wdhub/mechatronic-project/CAD_files-frame/bird-wings-mechanism-1.snapshot.3/bird wings/2.jpg

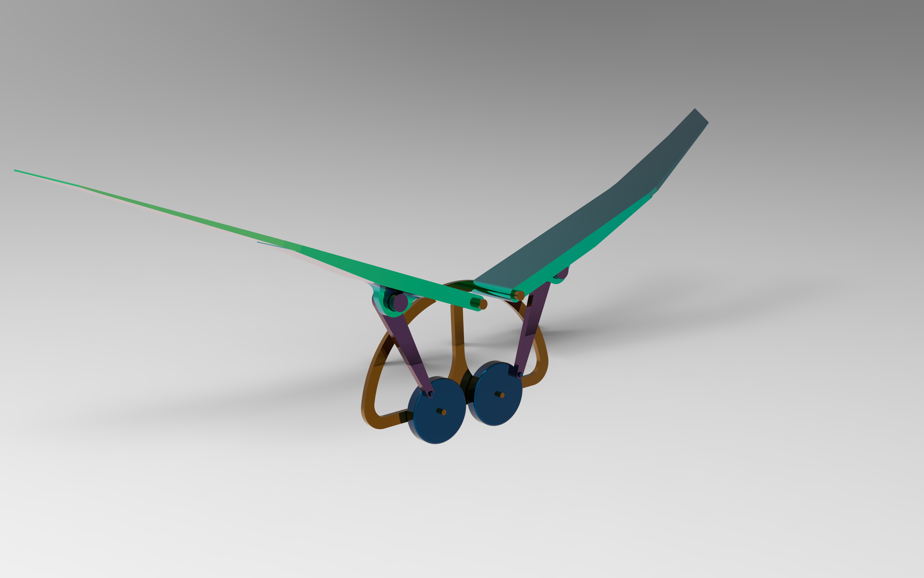
CAD_files-frame/bird-wings-mechanism-1.snapshot.3/bird wings/2.jpg
