wdhub/mechatronic-project/CAD_files-frame/flying-mechanism-1.snapshot.2/untitled.70.png

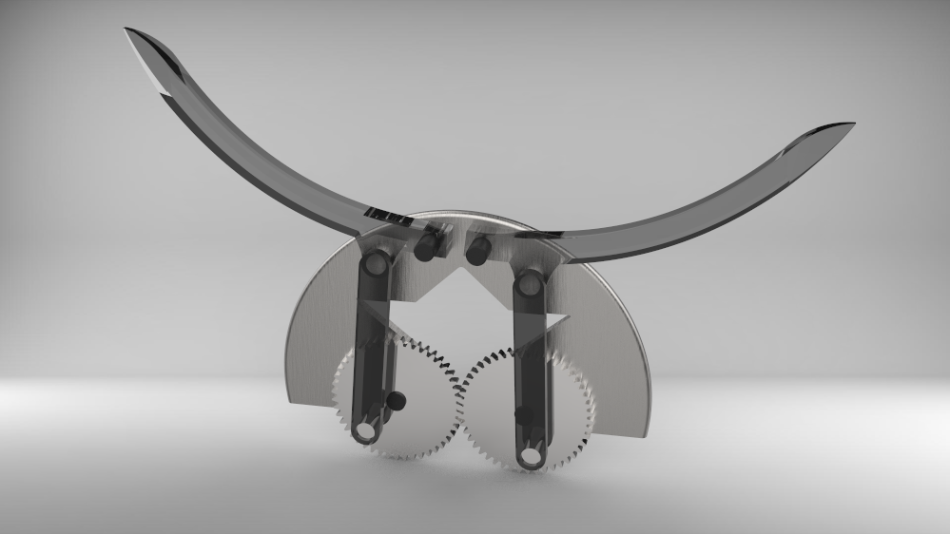
CAD_files-frame/flying-mechanism-1.snapshot.2/untitled.70.png
