wdhub/mechatronic-project/Origami_files_Instructables/Kinetic Origami 3D files-20221115T102837Z-001/Kinetic Origami 3D files/main_gearWithHole.stl

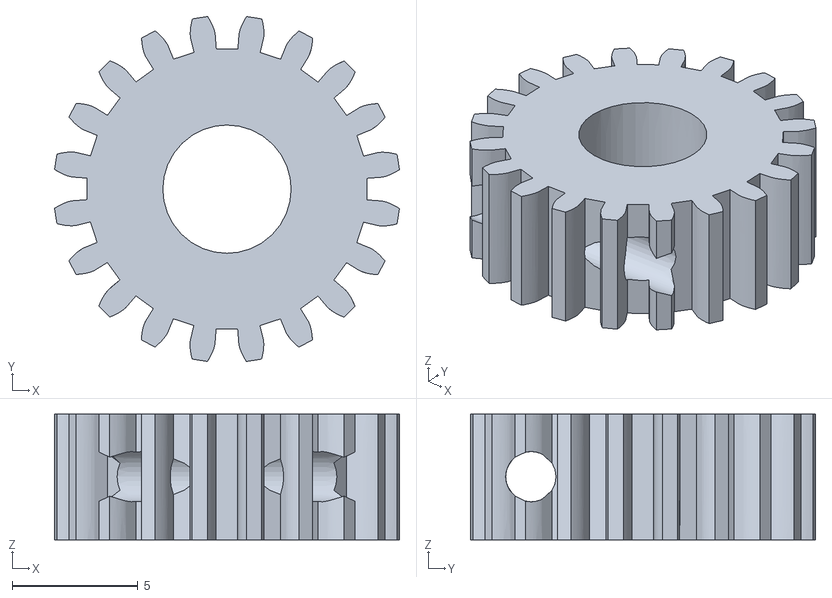
[picture p13: CAD file, 2022-11-28]
Origami_files_Instructables/Kinetic Origami 3D files-20221115T102837Z-001/Kinetic Origami 3D files/main_gearWithHole.stl
13.7 x 13.7 x 5.00
