wdhub/mechatronic-project/CAD_files-frame/flying-mechanism-1.snapshot.2/Assem1.SLDASM

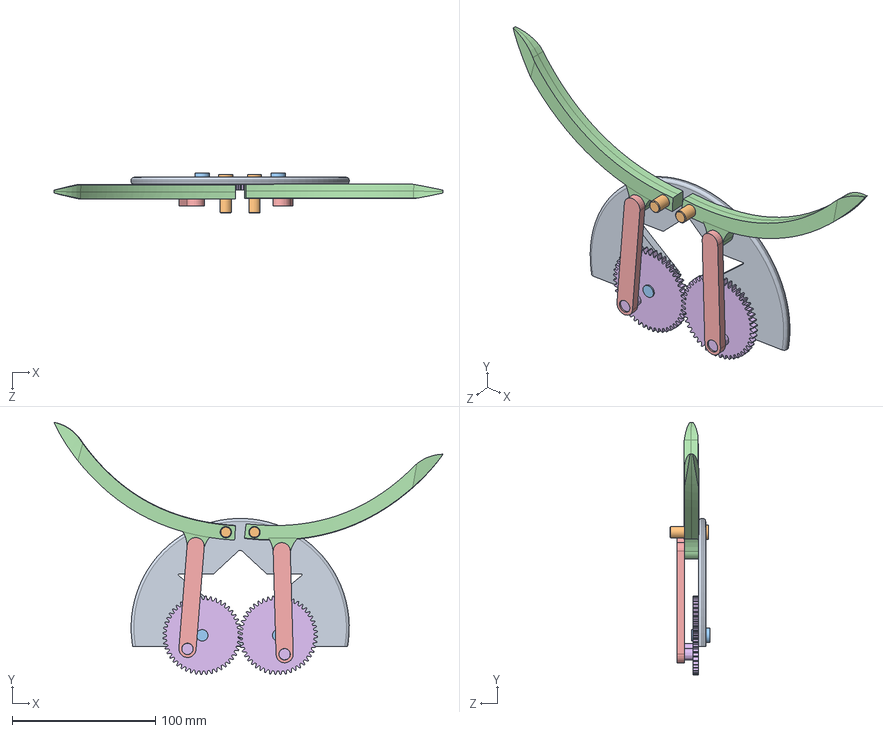
[picture p14: CAD file, 2022-12-14]
CAD_files-frame/flying-mechanism-1.snapshot.2/Assem1.SLDASM
271.6 x 176.3 x 28.0 mm
wing x 2
spur gear_ x 2
