wdhub/mechatronic-project/Origami_files_Instructables/Kinetic Origami 3D files-20221115T102837Z-001/Kinetic Origami 3D files/main_gearHolder.stl

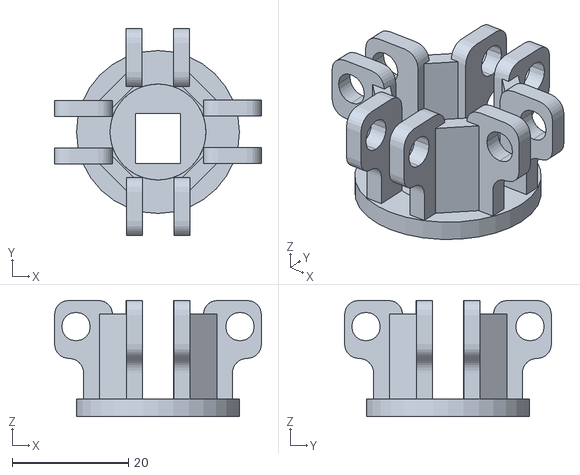
[picture p15: CAD file, 2022-11-28]
Origami_files_Instructables/Kinetic Origami 3D files-20221115T102837Z-001/Kinetic Origami 3D files/main_gearHolder.stl
35.6 x 35.6 x 20.0
