wdhub/mechatronic-project/CAD-20221125T085707Z-001/CAD/cylinder-1.stl

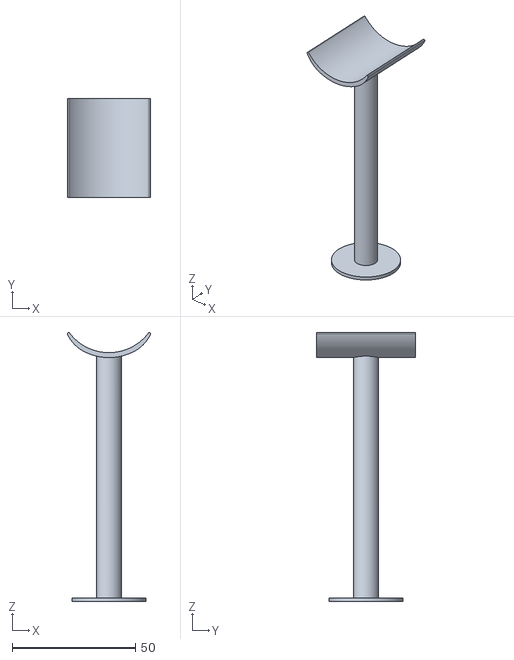
[picture p16: CAD file, 2022-12-14]
CAD-20221125T085707Z-001/CAD/cylinder-1.stl
33.7 x 40.0 x 109.0
