wdhub/mechatronic-project/CAD_files-frame/flying-mechanism-1.snapshot.2/Part8.SLDPRT

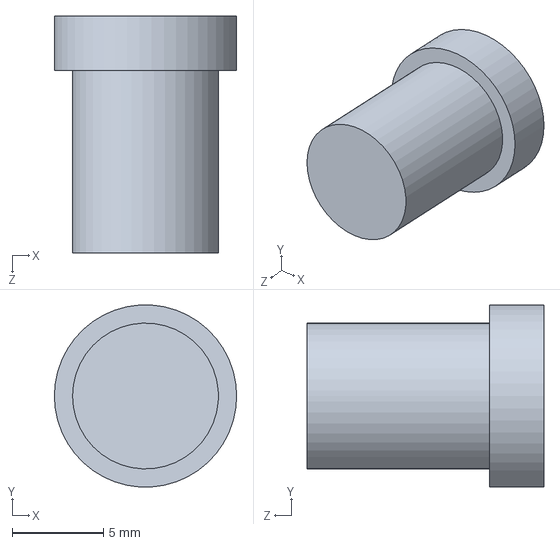
[picture p17: CAD file, 2022-12-14]
CAD_files-frame/flying-mechanism-1.snapshot.2/Part8.SLDPRT
10.0 x 9.98 x 13.0 mm
