wdhub/mechatronic-project/CAD-20221125T085707Z-001/CAD/Base-Bottom-1.stl

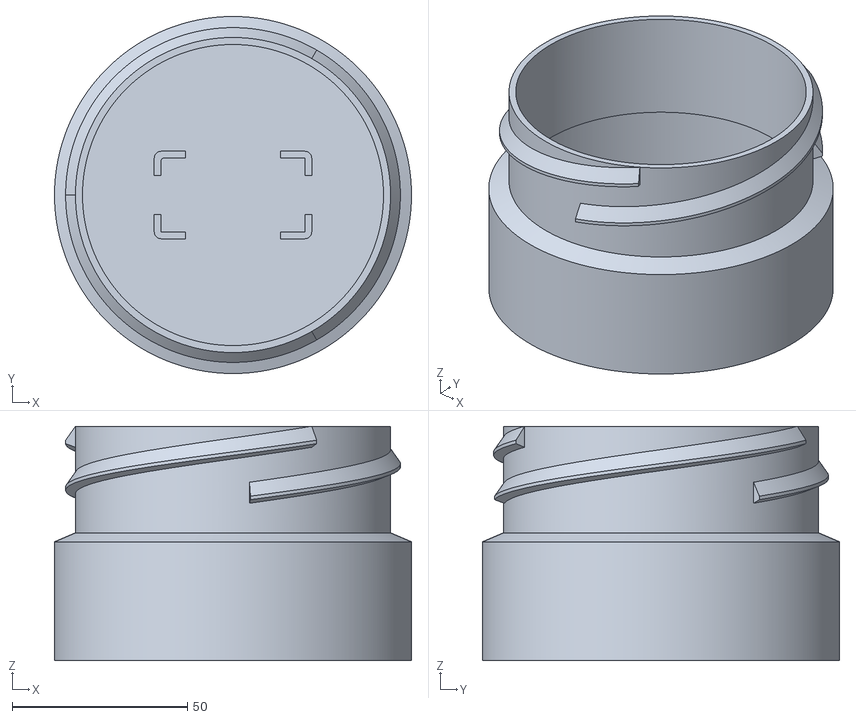
[picture p18: CAD file, 2022-12-14]
CAD-20221125T085707Z-001/CAD/Base-Bottom-1.stl
102.0 x 102.0 x 67.0
