wdhub/mechatronic-project/CAD_files-frame/flying-mechanism-1.snapshot.2/Part10.SLDPRT

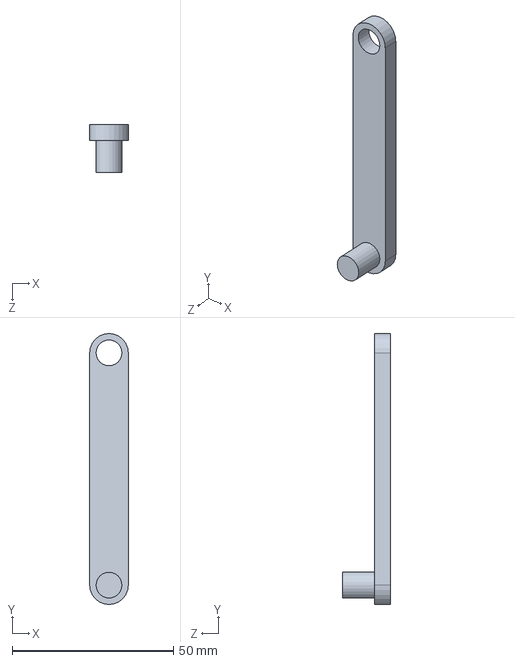
[picture p19: CAD file, 2022-12-14]
CAD_files-frame/flying-mechanism-1.snapshot.2/Part10.SLDPRT
12.0 x 84.0 x 15.0 mm
