wdhub/mechatronic-project/Origami_files_Instructables/Kinetic Origami 3D files-20221115T102837Z-001/Kinetic Origami 3D files/servo_gear.stl

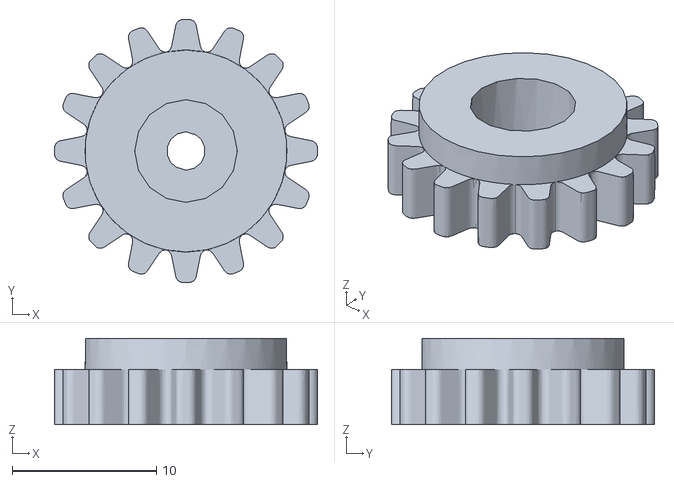
[picture p20: CAD file, 2022-11-28]
Origami_files_Instructables/Kinetic Origami 3D files-20221115T102837Z-001/Kinetic Origami 3D files/servo_gear.stl
18.2 x 18.2 x 5.97
