wdhub/mechatronic-project/Origami_files_Instructables/Kinetic Origami 3D files-20221115T102837Z-001/Kinetic Origami 3D files/servo_holder.stl

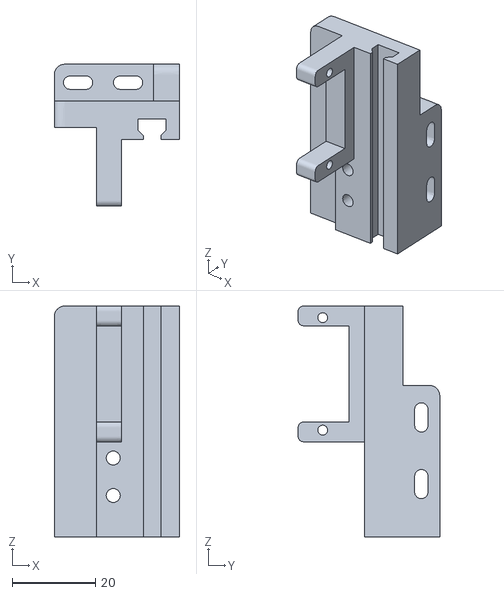
[picture p21: CAD file, 2022-11-28]
Origami_files_Instructables/Kinetic Origami 3D files-20221115T102837Z-001/Kinetic Origami 3D files/servo_holder.stl
30.1 x 34.0 x 55.5
