wdhub/mechatronic-project/CAD_files-frame/flying-mechanism-1.snapshot.2/wing.SLDPRT

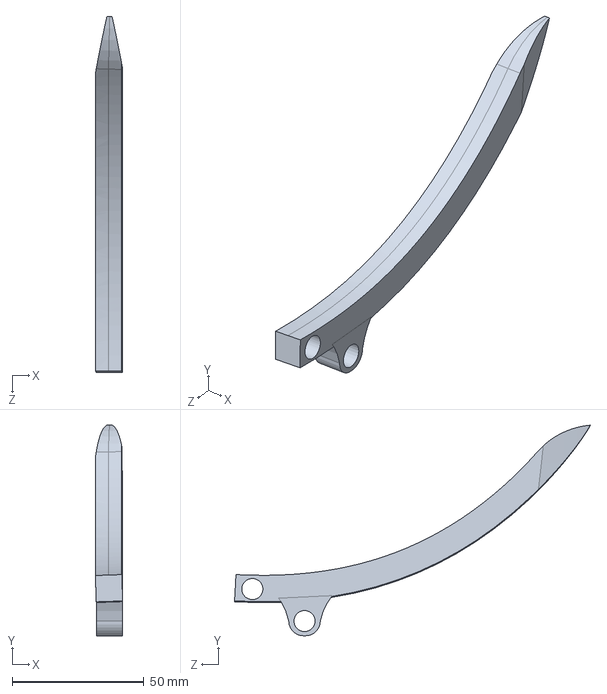
[picture p22: CAD file, 2022-12-14]
CAD_files-frame/flying-mechanism-1.snapshot.2/wing.SLDPRT
10.3 x 79.9 x 135.0 mm
