wdhub/mechatronic-project/Origami_files_Instructables/Kinetic Origami 3D files-20221115T102837Z-001/Kinetic Origami 3D files/padbase.stl

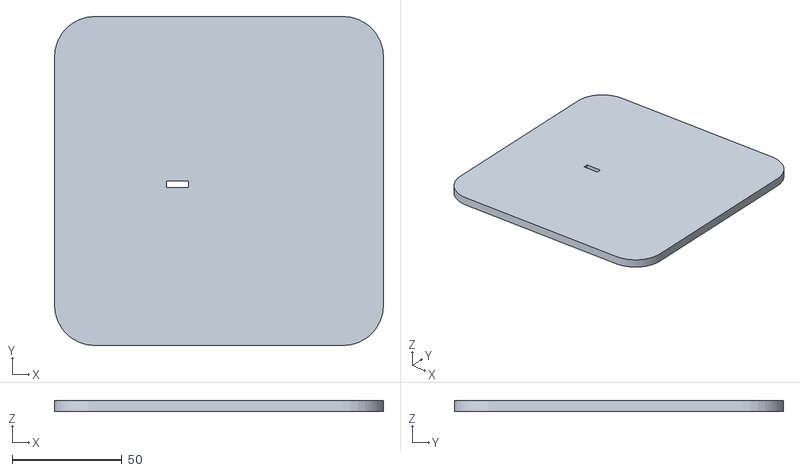
[picture p23: CAD file, 2022-11-28]
Origami_files_Instructables/Kinetic Origami 3D files-20221115T102837Z-001/Kinetic Origami 3D files/padbase.stl
150.0 x 150.0 x 5.00
