wdhub/mechatronic-project/CAD_files-frame/flying-mechanism-1.snapshot.2/Part5.SLDPRT

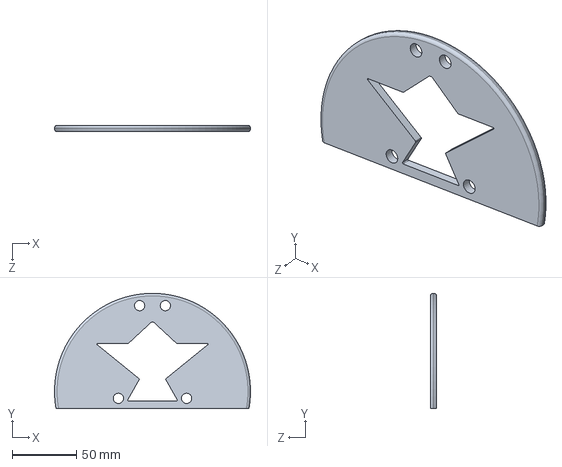
[picture p24: CAD file, 2022-12-14]
CAD_files-frame/flying-mechanism-1.snapshot.2/Part5.SLDPRT
152.3 x 89.6 x 5.00 mm
