wdhub/mechatronic-project/CAD_files-frame/flying-mechanism-1.snapshot.2/spur gear_.SLDPRT

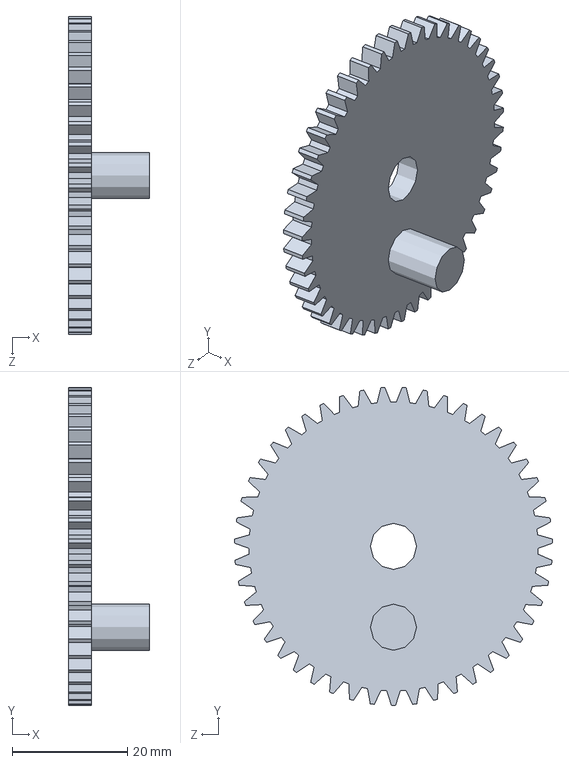
[picture p25: CAD file, 2022-12-14]
CAD_files-frame/flying-mechanism-1.snapshot.2/spur gear_.SLDPRT
14.0 x 55.1 x 55.1 mm
