wdhub/mechatronic-project/CAD_files-frame/flying-mechanism-1.snapshot.2/Part6.SLDPRT

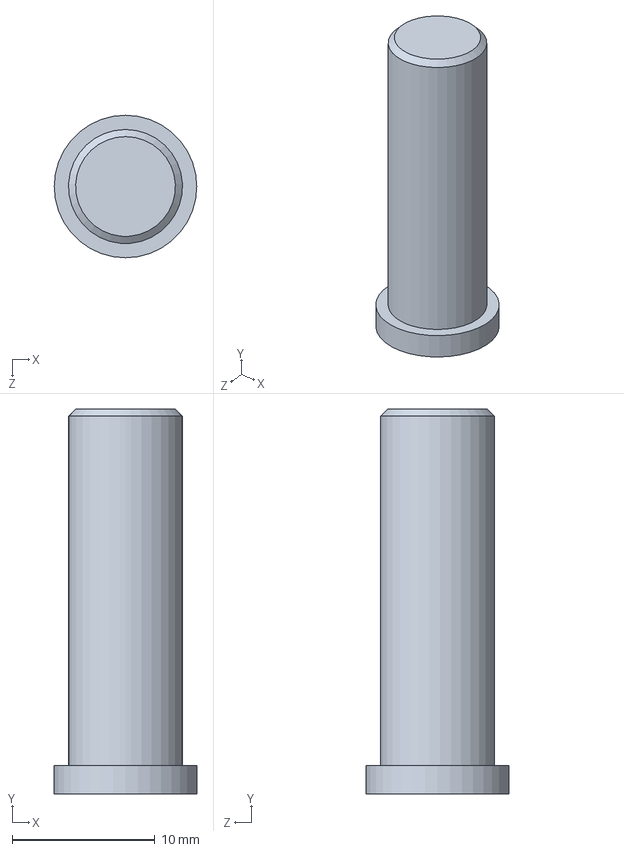
[picture p27: CAD file, 2022-12-14]
CAD_files-frame/flying-mechanism-1.snapshot.2/Part6.SLDPRT
10.0 x 27.0 x 10.0 mm
