wdhub/mechatronic-project/(list of files, cad)

Other CAD files:
CAD_files-frame/Cad-bird-new-20221201T201350Z-001/Cad-bird-new/arm1.dwg
CAD_files-frame/Cad-bird-new-20221201T201350Z-001/Cad-bird-new/gear31new.dwg
CAD_files-frame/bird-wings-mechanism-1.snapshot.3/bird wings/Asm1.x_t
CAD_files-frame/bird-wings-mechanism-1.snapshot.3/bird wings/Bird-Assembly_Rimmie/Wing-H.x_t
CAD_files-frame/bird-wings-mechanism-1.snapshot.3/bird wings/Bird-Assembly_Rimmie/Wing-V.x_t
CAD_files-frame/bird-wings-mechanism-1.snapshot.3/bird wings/Bird-Assembly_Rimmie/bird.x_t
CAD_files-frame/bird-wings-mechanism-1.snapshot.3/bird wings/Bird-Assembly_Rimmie/link-right.x_t
CAD_files-frame/bird-wings-mechanism-1.snapshot.3/bird wings/Bird-Assembly_Rimmie/servo-attach.x_t
CAD_files-frame/bird-wings-mechanism-1.snapshot.3/bird wings/Bird-Assembly_Rimmie/structure.x_t
CAD_files-frame/bird-wings-mechanism-1.snapshot.3/bird wings/Wing-H.x_t
CAD_files-frame/bird-wings-mechanism-1.snapshot.3/bird wings/Wing-V.x_t
CAD_files-frame/frame_assembly/structureV3.x_t
CAD_files-frame/frame_assembly/structure_v1.x_t
CAD_files-frame/frame_assembly/structure_v2.x_t
CAD_files-frame/frame_assembly/structure_v4.x_t
