wdhub/mechatronic-project/CAD_files-frame/gear31.pdf

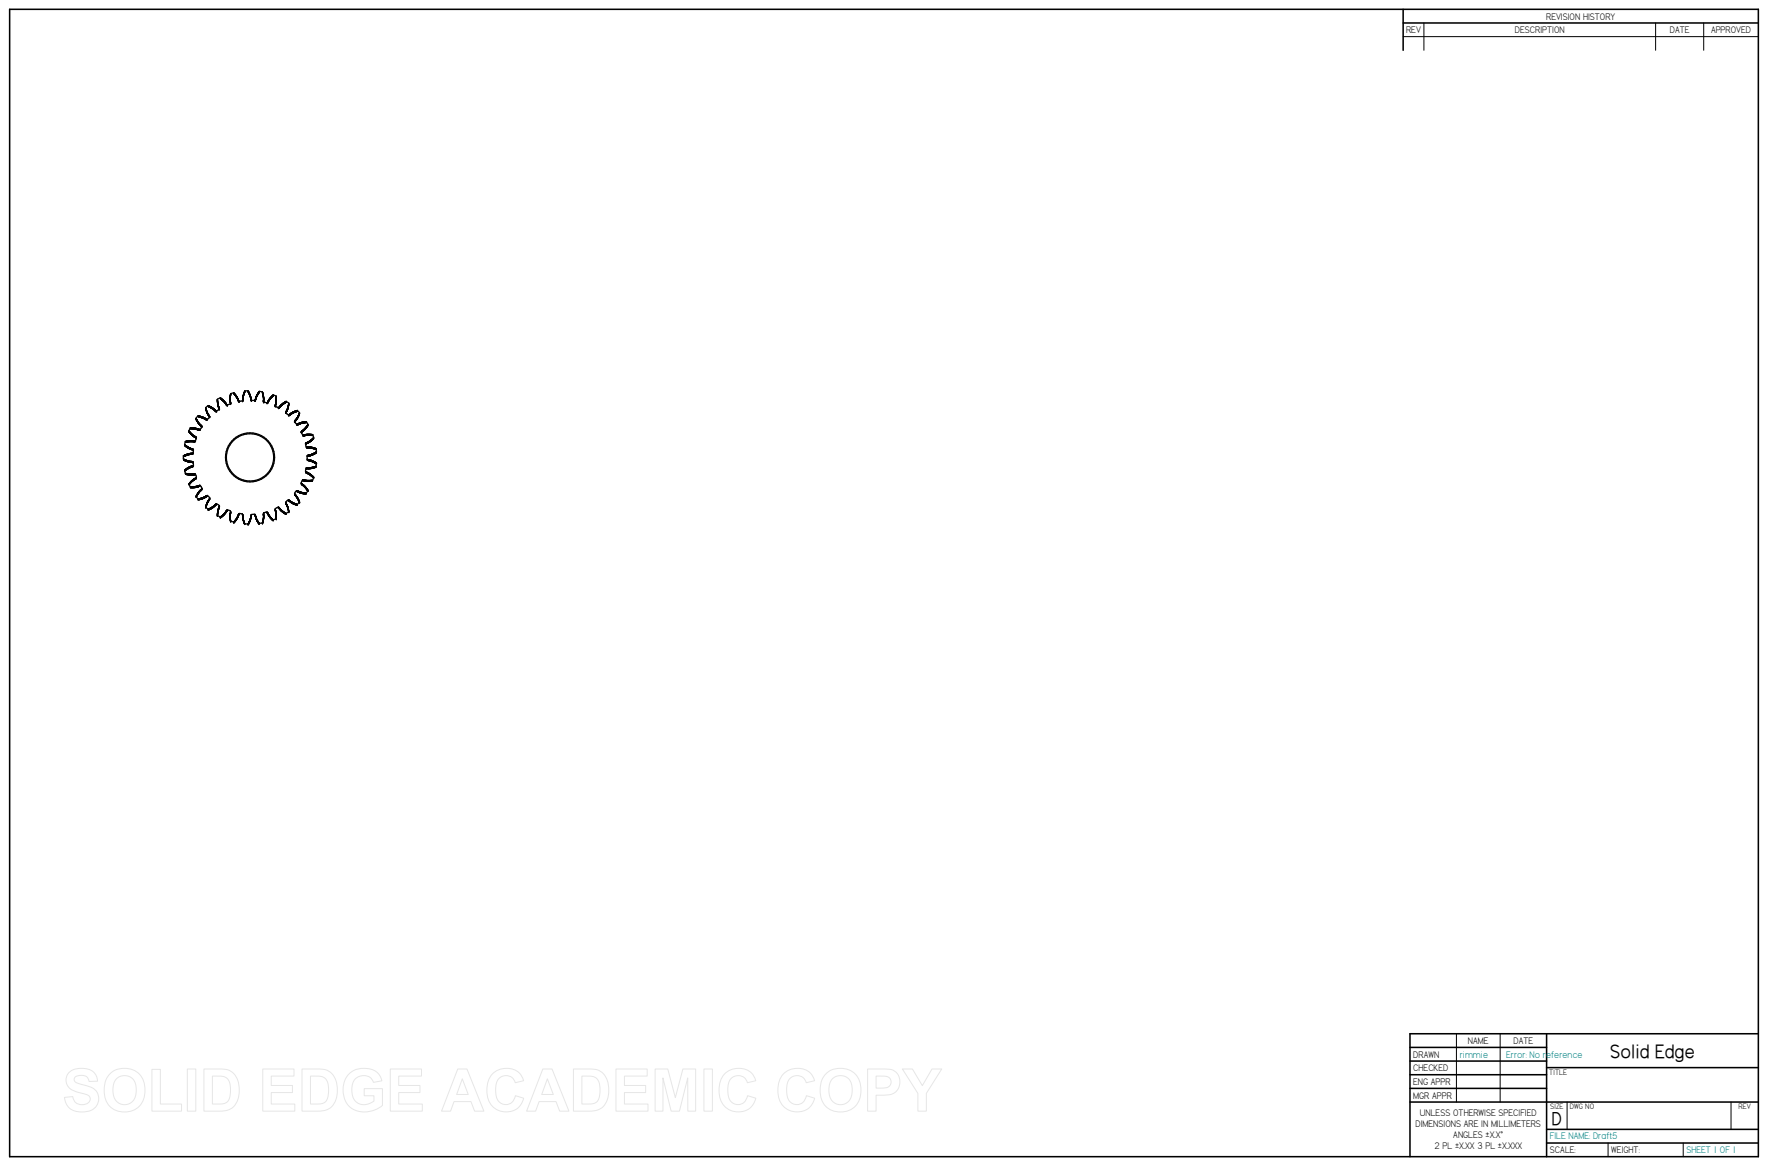
[picture p45: page 1]
TITLE; FILE NAME: Draft5; SCALE:; WEIGHT:; SHEET 1 OF 1

REVISION HISTORY

REV | DESCRIPTION | DATE | APPROVED

NAME | DATE Error: No reference | Solid Edge

DRAWN | rimmie
CHECKED
ENG APPR
MGR APPR
UNLESS OTHERWISE SPECIFIED DIMENSIONS ARE IN MILLIMETERS ANGLES ±X.X° 2 PL ±X.XX 3 PL ±X.XXX | SIZE D | DWG NO | REV
