wdhub/mechatronic-project/CAD_files-frame/structure_v2.pdf

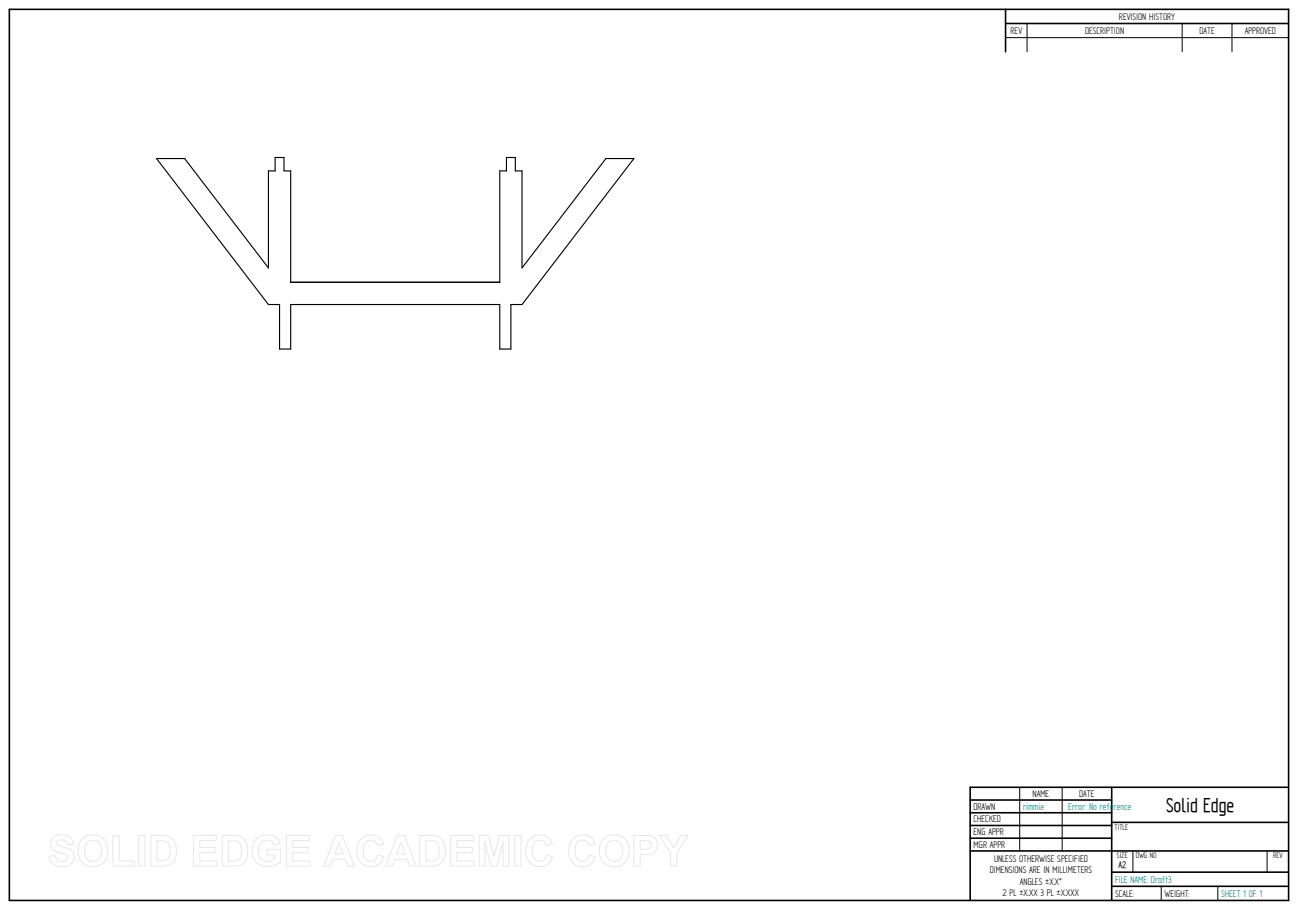
[picture p46: page 1]
TITLE; FILE NAME: Draft3; SCALE:; WEIGHT:; SHEET 1 OF 1

REVISION HISTORY

REV | DESCRIPTION | DATE | APPROVED

NAME | DATE | Solid Edge

DRAWN | rimmie | Error: No reference
CHECKED
ENG APPR
MGR APPR
UNLESS OTHERWISE SPECIFIED DIMENSIONS ARE IN MILLIMETERS ANGLES ±X.X° 2 PL ±X.XX 3 PL ±X.XXX | SIZE A2 | DWG NO | REV
