wdhub/mechatronic-project/DC_Control/DC_hbridge/DC_hbridge.ino

// Motor A
#include <Wire.h>
#include <MPU6050.h>
#include <Servo.h>
 
int enA = 9;
int in1 = 4;
int in2 = 5;
MPU6050 mpu;
int speed;

void setup()
 
{
 
  // Set all the motor control pins to outputs
 
  pinMode(enA, OUTPUT);
  pinMode(in1, OUTPUT);
  pinMode(in2, OUTPUT);

  Serial.begin(115200);
  
  // Initialize MPU6050
  Serial.println("Initialize MPU6050");
  while(!mpu.begin(MPU6050_SCALE_2000DPS, MPU6050_RANGE_2G))
  {
    Serial.println("Could not find a valid MPU6050 sensor, check wiring!");
    delay(500);
  }
  mpu.calibrateGyro();

  // Set threshold sensivty. Default 3.
  // If you don't want use threshold, comment this line or set 0.
  mpu.setThreshold(3);
  
  // Check settings
  checkSettings();

   
  demoOne();
}

void checkSettings()
{
  Serial.println();
  
  Serial.print(" * Sleep Mode:        ");
  Serial.println(mpu.getSleepEnabled() ? "Enabled" : "Disabled");
  
  Serial.print(" * Clock Source:      ");
  switch(mpu.getClockSource())
  {
    case MPU6050_CLOCK_KEEP_RESET:     Serial.println("Stops the clock and keeps the timing generator in reset"); break;
    case MPU6050_CLOCK_EXTERNAL_19MHZ: Serial.println("PLL with external 19.2MHz reference"); break;
    case MPU6050_CLOCK_EXTERNAL_32KHZ: Serial.println("PLL with external 32.768kHz reference"); break;
    case MPU6050_CLOCK_PLL_ZGYRO:      Serial.println("PLL with Z axis gyroscope reference"); break;
    case MPU6050_CLOCK_PLL_YGYRO:      Serial.println("PLL with Y axis gyroscope reference"); break;
    case MPU6050_CLOCK_PLL_XGYRO:      Serial.println("PLL with X axis gyroscope reference"); break;
    case MPU6050_CLOCK_INTERNAL_8MHZ:  Serial.println("Internal 8MHz oscillator"); break;
  }
  
  Serial.print(" * Gyroscope:         ");
  switch(mpu.getScale())
  {
    case MPU6050_SCALE_2000DPS:        Serial.println("2000 dps"); break;
    case MPU6050_SCALE_1000DPS:        Serial.println("1000 dps"); break;
    case MPU6050_SCALE_500DPS:         Serial.println("500 dps"); break;
    case MPU6050_SCALE_250DPS:         Serial.println("250 dps"); break;
  } 
  
  Serial.print(" * Gyroscope offsets: ");
  Serial.print(mpu.getGyroOffsetX());
  Serial.print(" / ");
  Serial.print(mpu.getGyroOffsetY());
  Serial.print(" / ");
  Serial.println(mpu.getGyroOffsetZ());
  
  Serial.println();
}
 
void demoOne()
 
{
 
  // This function will run the motor at a fixed speed
 
  // Turn on motor A
 
  digitalWrite(in1, HIGH);
  digitalWrite(in2, LOW);
  delay(1000);

}
 
void demoTwo()
 
{
  Serial.println("running demo2");  
  Vector rawGyro = mpu.readRawGyro();
  Vector normGyro = mpu.readNormalizeGyro();
  speed=map(rawGyro.YAxis,-5000,5000,0,250);
  analogWrite(enA, speed);
  Serial.println(speed); 


 
  // Now turn off motors
 /*
  digitalWrite(in1, LOW);
  digitalWrite(in2, LOW);
  */
  Serial.println(rawGyro.YAxis);  
}
 
void loop()
 
{
 
  demoTwo();
 
  delay(10);
 
}
