wdhub/mechatronic-project/(commit log)

2022-11-16 codes for IMU
2022-11-17 bluetooth arduino android
    Code for connecting bluetooth to arduino and control it using andriod app
2022-11-23 servo control
2022-11-23 Controlling servo with IMU sensor
2022-11-25 cad files
    [Spur Gear 28 & 29 Teeth.cfg, frame.cfg]
2022-11-28 sensor_sound interaction
2022-11-28 sensor sound interaction
2022-12-05 sensor+motor+processing
    delay needs to be adjusted.
